tAiNgUyEnVaNn/Analog-Electronics/Nhóm 10_Report_Final.pdf

# BÁO CÁO BÀI TẬP LỚN

Học phần: Điện tử tương tự 1 | Mã Lớp:150141 | Thời khóa biểu: Thứ 3, phòng: TC-308

Nhóm số: 10

Họ tên | MSSV | Phân công công việc
Nguyễn Văn Tài | 20214082 | - Tính toán thông số lý thuyết mạch nguyên lý - Hiệu chỉnh mạch - Thiết kế PCB, đặt hàng và hàn PCB - Làm báo cáo phần phân tích thiết kế; tính toán lý thuyết; kết luận
Lê Văn Minh | 20214001 | - Mô phỏng mạch và đo thông số mô phỏng - Làm báo cáo phần mô phỏng mạch
Đặng Thanh Hải | 20210310 | - Thực hiện mạch thử nghiệm trên breadboard; đo thông số thực tế trên breadboad và PCB - Làm báo cáo phần đo đạc thực tế
Đoàn Minh Quang | 20214047 | - Tham chiếu thông số yêu cầu và chọn linh kiện phù hợp - Tổng hợp số liệu lý thuyết, mô phỏng, thực tế và đánh giá sai số, nguyên nhân sai số (nếu có)

==================================================================================

Đề tài số: 06

Yêu cầu thiết kế: Thiết kế mạch khuếch đại âm thanh đáp ứng các yêu cầu kỹ thuật: công suất ra trên tải 1.5W, tải loa 4 Ω, tín hiệu đầu vào hiệu dụng 100mV.

==================================================================================

### 1. PHÂN TÍCH THIẾT KẾ

Phân tích: Do công suất ra là Pout = 1. 5 W, điện trở loa là RL = 4 Ω, sử dụng nguồn nuôi 12V

Nên điện áp đầu ra của mạch khuếch đại chế độ đẩy kéo AB là Vout, rms = √Pout ∗ RL ≈ 2.5 Vrms

Tầng 1 là tầng khuếch đại điện áp. Các tầng 2 và 3 chỉ cần khuếch đại dòng điện, không cần khuếch đại điện áp, nên điện áp ra của tầng 1 chính là xấp xỉ điện áp ra của toàn mạch. Nên:

Vout1, rms > 2.5 V

Do yêu cầu đề bài điện áp hiệu dụng tín hiệu vào là 100mV. Nên từ đo ta tính toán được hệ số khuếch đại điện áp tối thiểu của tầng 1:

AV1 >

Vout1, rms

Vin, rms

= 25 (lần)

Yêu cầu đáp ứng tần số toàn mạch tối thiểu nằm trong vùng từ 100Hz đến 10Khz

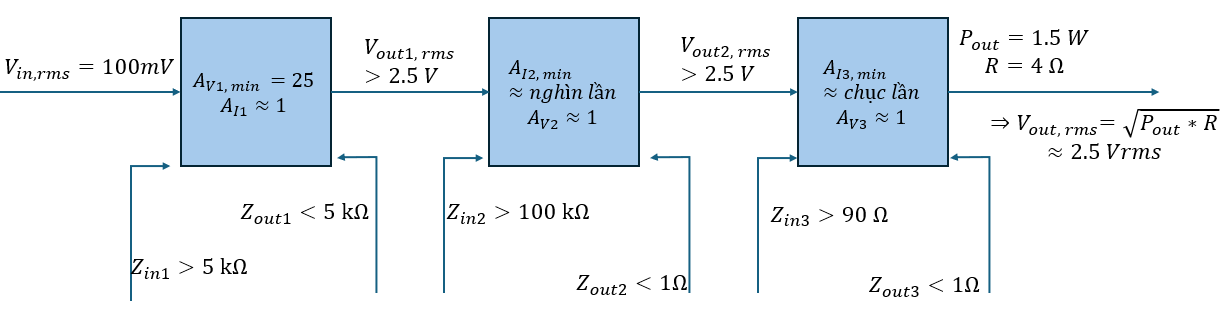
[picture p1: figure]

### 1.1. Tầng khuếch đại 1 (Khuếch đại điện áp)

- Yêu cầu tầng khuếch đại 1:
- AV1 > 25 (lần)
- Để phối hợp trở kháng tốt với nguồn và các tải: Zin1 > 5kΩ và Zout1 < 5kΩ
- Đáp ứng tần số: f ε (20Hz; 20kHz)
- Kiến trúc sử dụng: Tầng khuếch đại tín hiệu E chung (CE), phân cực theo kiểu phân áp (Voltage divide)
- Transitor sử dụng: 2N2222A

### 1.2. Tầng khuếch đại 2 (Khuếch đại dòng điện)

Do dòng điện từ đầu vào không được khuếch đại ở tầng đầu tiên thậm chí còn bị suy giảm bởi phối hợp trở kháng. Nên nếu đưa tín hiệu trực tiếp vào tầng khuếch đại công suất, đường tải tĩnh bị thấp xuống dẫn đến công suất cũng như hiệu suất bị suy giảm. Tầng khuếch đại 2 này cũng được sử dụng như một bộ đệm tín hiệu (đáp ứng phối hợp trở kháng giữa tầng 1 và tầng 3)
- Yêu cầu tầng khuếch đại 2:
- AI2 ≈ vài ngℎìn lần
- Để phối hợp trở kháng tốt giữa tầng 1 và tầng 3: Zin2 > 100kΩ và Zout2 < 1Ω
- Đáp ứng tần số: f ε (20Hz; 20kHz)
- Kiến trúc sử dụng: Tầng khuếch đại tín hiệu C chung (CC), mắc theo kiểu Darlington
- Transistor sử dụng: 2N2222A và TIP41C (do cần phải chịu dòng điện cao)

### 1.3. Tầng khuếch đại 3 (Khuếch đại công suất)

- Yêu cầu tầng khuếch đại 3:
- AI3 ≈ vài cℎục lần
- Để phối hợp trở kháng tốt giữa tầng 2 và loa: Zin3 > 90Ω và Zout3 < 1Ω
- Đáp ứng tần số: f ε (20Hz; 20kHz)
- Kiến trúc sử dụng: Tầng khuếch đại công suất đẩy kéo chế độ AB, mắc theo kiểu C chung (CC)
- Transistor sử dụng: TIP41C và TIP42C (do làm việc với công suất cao)

### 2. TÍNH TOÁN LÝ THUYẾT

### 2.1. Tầng khuếch đại 1 (Khuếch đại điện áp)

Dựa vào kiến trúc và yêu cầu của phần 1. Ta có sơ đồ cần thực hiện như sau:

Chọn
{

Transistor: 2N2222A có {

β = 300
VBEon ≈ 0.7 V
VT =

kq
T (°K)

= 26 mV
Hệ số kℎuếcℎ đại: G = 30 lần Tần số ℎoạt động: (20Hz ÷ 20kHz)

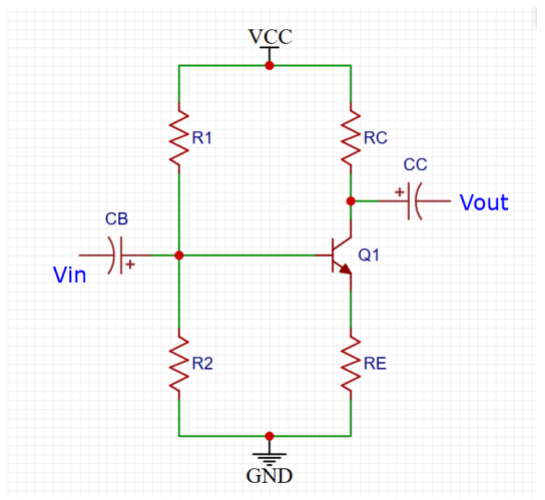
[picture p2: figure]

Đối với BJT ứng dụng khuếch đại, ta cần phân cực điểm Q nằm trong vùng tích cực (active region). Để hạn chế tín hiệu ra bị méo và để tăng hiệu suất tầng khuếch đại công suất, nên điểm Q cần nằm chính giữa đường tải tĩnh. Nên:

ICQ =

ICmax
2

=

VCC
2(RC + RE)

⇔ RE =

VCC
2IC

− RC (2.1.1)

Đối với mạch khuếch đại E chung, hệ số khuếch đại điện áp của mạch là (coi như dùng giá trị tuyệt đối):

G =

RC
1
gm

+ RE

⇔ G (

VT
IC

+

VCC
2IC

− RC) = RC ⇔ IC =

G(VCC + 2VT

| )
2RC(1 + G)

(2.1.2)

Ta có thể thấy biểu thức 2.1.2 chỉ rõ sự phụ thuộc của Ic vào Rc thỏa mãn điều kiện ở công thức 2.1.1 (điểm Q nằm chính giữa đường tải tĩnh). Đồng thời với việc để chọn giá trị trở theo các giá trị mặc định của nhà sản xuất (hạn chế việc nối tiếp nhiều trở), ta thấy RC tăng thì hệ số khuếch đại tăng nhưng trở kháng ra lại giảm. Nên để cân bằng thông thường ta chọn Rc trong khoảng từ (1kΩ ÷ 10kΩ).

Ta chọn RC = 2 kΩ ⇒ {
IC =

30∗(12+2∗26(mV)
2∗2(kΩ)∗(1+30)

≈ 2.92 mA

RE =

12
2∗2.92(mA)

−2(kΩ) ≈ 54.8 Ω. Cℎọn RE = 56 Ω

Điện áp tại cực B được tính theo 2 cách: Theo phân áp qua R1, R2 và thông qua định luật Kirchoff về điện áp:

VB = VCC

R2
R1 + R2

= VBEon + ICRE ⇔ R1 =

VCCR2

VBEon + ICRE

− R2

R1
R1 + R2

=

VB

VCC

=

0.7 +2.92m ∗ 56
12 | ≈ 0.08

Ta thấy, giá trị IC cỡ mA, nên giá trị IB nhỏ cỡ μA. Do đó, giá trị IB có thể xấp xỉ 0. Khi đó, R1 và R2 có thể được coi là nối tiếp nhau, và IR1 ≫ IB. Thông thường ta lấy:

IR1 ≥ 10IB ⇔ R1 ≤

VR1
10IB

=

β(VCC − VB)
10IC

=

300 ∗ (12 − 0.7 − 2.92(mA) ∗ 56)
| 10 ∗ 2.92(mA)

≈ 114 kΩ

Chọn R1 = 100 kΩ ⇒ R2 =

(0.7+2.92m∗56)∗100k
12−0.7−2.92m∗56

≈ 9.4kΩ. Nên cℎọn R2 ≈ 10kΩ.

Tính toán lại các thông số 1 chiều và xoay chiều:

Chế độ 1 chiều (DC mode): IC = β

VTH−VBEon
RTH+(β+1)RE

≈ 3.2 mA ≈

VCC 2(RC+RE) | = 2.92 mA ⇒ Q nằm gần giữa đường tải

VCE = VCC −IC

(RC +RE

) = 12 − 3.2m ∗ (2k + 56) = 5.4 (V)

Chế độ xoay chiều (DC mode):

{

AV,1 = −

RC
VT
IC

+RE

≈ −31 lần

Zin,1 = R1 ∥ R2 ∥ [(rπ + (1 + β) ∗ RE

] ≈ 100k ∥ 10k ∥ 19k ≈ 6 kΩ; Với rπ =

β
gm
Zout,1 ≈ RC = 2 kΩ

Đáp ứng tần số: Các tụ nối tầng mắc theo kiểu DC-Block tạo thành mô hình lọc thông cao (HPF)

fLB =

1
2πZinCB

< fL Hz ⇒ CB >

1
2πfLZin

=

1
2π ∗ 20 ∗ 6k

≈ 1.32 (μF). Cℎọn CB = 47μF do pℎổ biến

fLC =

1

2πZoutCC

< fL ⇒ CC >

1

2πfLZout

=

1
2π ∗ 20 ∗ 2k

≈ 4 (μF). Cℎọn CC = 47uF do pℎổ biến

### 2.2. Tầng khuếch đại 2 (Khuếch đại dòng điện)

Dựa vào kiến trúc và yêu cầu của phần 1: Mạch khuếch đại C chung, mắc theo kiểu Darlington để tăng hệ số khuếch đại dòng điện. Ta có sơ đồ cần thực hiện như sau:

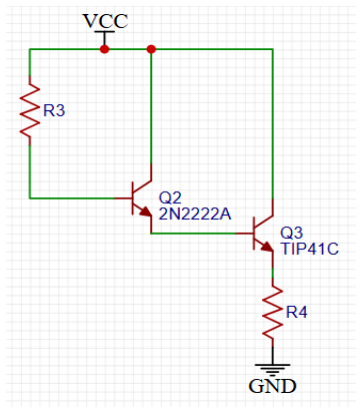
[picture p3: figure]

Với: {

2N222A (Q2): {

VBEon ≈ 0.7 V
β2 = 300
TIP 41C (Q3): {

VBEon ≈ 0.67 V
β3 = 35

IC3 = βD

VCC − VBED
R3 + βDR4

Để điểm làm việc tĩnh của Q3 nằm chính giữa đường tải: IC3 =

1
2

IC3,max =

1
2

VCC
R4

⇔ βD

VCC − VBED
R3 +βDR4

=

1
2

VCC
R4

⇔ RB =

βDRE(VCC − VBED)

VCC

Mặt khác VCE là vùng sinh của tín hiệu xoay chiều. Nên tín hiệu đầu ra của tầng 1 không được vượt quá VCE3.

Ta chọn R4 = 33 (Ω) => R3 ≈ 208 (kΩ). Cℎọn R3 = 200 (kΩ)

Tính toán lại các thông số 1 chiều và xoay chiều:

Chế độ 1 chiều (DC mode):
{

IC3 =

Vcc−VBED
R3+βDR4

≈ 184 mA ≈

VCC
2R4

= 181 mA ⇒ Q nằm giữa đường tải VCE3 = VCC −IC ∗ R4 = 12 − 181m ∗ 33 = 6.027 V IC2 =

IC3
β3

=

181m
35

≈ 5.17 mA
VCE2 = VCC − VE3 − VBE3 = 12− 8.507 − 0.67 = 5.3 V

Chế độ xoay chiều (AC mode):
{

AI,2 ≈ −

βDR3
R3+βDR4

≈ 6060 lần
Zin,2 = R3 ∥ βDR4 = 200k ∥ 346k ≈ 126 kΩ

Zout,2 =

1
gm2β3

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
≈ 0.14 Ω
AV,2 ≈ 1 lần

### 2.3. Tầng khuếch đại 3 (Khuếch đại công suất)

Ở tầng khuếch đại công suất, ta sử dụng mô hình khuếch đại công suất đẩy-kéo chế độ AB. Vì ở chế độ này, mỗi transitor khuếch đại một nửa chu kỳ nên hiệu suất của mạch đạt tốt hơn. Cùng với đó, công suất tiêu tán của tầng khuếch đại công suất được chia cho 2 transistor nên nhiệt tỏa ra của mỗi transistor sẽ giảm, nên transistor sẽ bền hơn.
{
TIP41C (Q4) và TIP42C (Q5): {

VBEon ≈ 0.67 V
β4 = β5 = 35 lần
Diode (1N4007)D1 và D2: VBEon ≈ 0.7 V

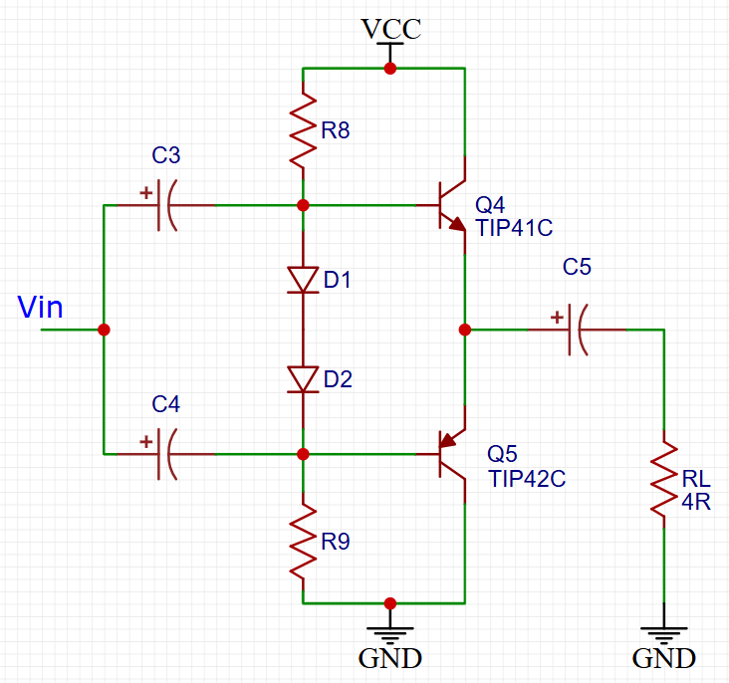
[picture p4: figure]

Nguyên lý hoạt động:

- Ở nửa chu kỳ dương: Q4 mở, Q5 ngắt. Tín hiệu AC từ Vin qua Q4 được đưa ra tải RL đồng thời tụ C5 được nạp bởi tín hiệu DC
- Ở nửa chu kỳ âm: Q4 ngắt, Q5 mở. Tụ C5 phóng điện làm nguồn nuôi của Q5 ở nửa chu kỳ âm. Nên tụ C5 cần có giá trị lớn. Tín hiệu từ Vin qua Q5 được đưa ra tải
- 2 diode tạo điện áp rơi xấp xỉ điện áp mở của Q4 và Q5, tạo phân cực ban đầu và cải thiện hiện tượng méo xuyên tâm (cross over distortion).

Do mạch khuếch đại ở chế độ AB nên điểm Q được phân cực sát với vùng cut-off {

VCEQ ≈ VCEmax

ICQ ≪ ICmax =

VCC
RL

≈ 3A

Ta có thể quan sát thấy đây là 2 mạch khuếch đại mắc theo kiểu C chung hoạt động độc lập ở 2 nửa chu kỳ. Dòng điện qua điện trở R8 bằng dòng điện qua điện trở R9. Nên R8=R9:

IR8 =

VCC − VD1 − VD2
2R8

Chọn R8 = 430 Ω ⇒ IR8 ≈ 12.3 (mA). Giá trị của IB nhỏ hơn dòng điện qua điện trở R8 do diode không lý tưởng thường tồn tại trở kháng.

Lấy IBQ,4 = −IBQ,5 ≈ 8 (mA) => ICQ,4 = ICQ,5 ≈ 280 (mA) ≪ ICmax ⇒ gm4 = gm5 ≈ 10,76 (S)

⇒ rπ4 = rπ5 =

β
gm

≈ 3.25 Ω

Tính toán lại các thông số 1 chiều và xoay chiều:

Chế độ 1 chiều (DC mode): IC3 =

Vcc−VBED
R3+βDR4

≈ 184 mA ≈

VCC
2R4

= 181 mA ⇒ Q nằm giữa đường tải

Chế độ xoay chiều (AC mode): {

AV ≈ 1 lần
Zin,3 = R8 ∥ R9 ∥ (rπ4 + (1 + β4

)RL

) = 235 ∥ 148 ≈ 91Ω

Zout,3 =

1

gm4

≈ 0.1 Ω

### 2.4. Tính hệ số khuếch đại điện áp toàn mạch và hiệu suất khuếch đại công suất

Hệ số khuếch đại điện áp toàn mạch:

AV,total = AV,1

Zin,2

Zin,2 +Zout1

AV,2

Zin,3

Zin,3 + Zout,2

AV,3

RL

RL + Zout,3

≈ 27 (lần)

Điện áp ra trên tải là: VL

(rms) = 27 ∗ 100(mVrms) = 2.7 (Vrms)

Công suất đưa ra tải: Pout, calc =

2.7

2

4

≈ 1.8 (W)

Công suất tiêu thụ tầng khuếch đại công suất: Pi (dc) = VCCIdc = VCC

2
π

VL(rms)√2
RL

≈ 7.3 (W)

Hiệu suất khuếch đại công suất: %η =

Pout, calc
Pi

(dc)

≈ 24.6 %

Công suất tiêu tán trên mỗi transistor: Pd, Q4 = Pd, Q5 = 2.75 (W)

### 2.5. Giải thích chức năng cần thiết của từng tầng

- Tầng 1: Là tầng khuếch đại tín hiệu nhỏ, liên quan trực tiếp tới công suất đầu ra được cho bởi công

thức: Pout =

AV ∗ Vin, rms

2

RL
- Tầng 2: Là tầng khuếch đại dòng điện, đồng thời là tầng “đệm” để phối hợp trở kháng giữa tầng 1 và tầng 3. Do Zout1 cỡ kΩ , Zin3 cỡ 100Ω. Nên nếu nối trực tiếp tầng 1 và tầng 3 mà không thông qua tầng Darlington thì phối hợp trở kháng không tốt dẫn đến tín hiệu bị suy hao khi đi vào tầng 3

### 3. MÔ PHỎNG MẠCH VÀ ĐO ĐẠC

### 3.1. Mô phỏng mạch ở chế độ một chiều (DC mode)

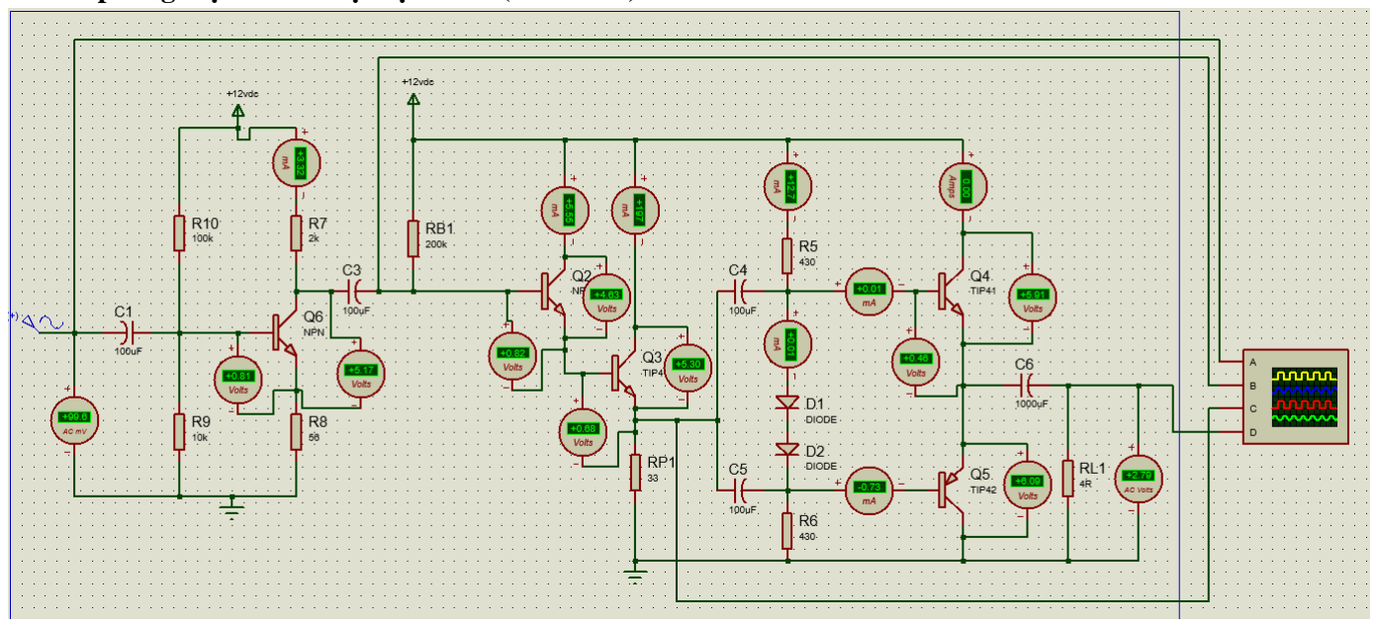
[picture p5: figure]

Kết quả mô phỏng được trình bày ở phần So sánh, đánh giá, nhận xét

### 3.2. Mô phỏng mạch ở chế độ xoay chiều (AC mode). Với Vin(rms) = 100 (mV), f = 1 (kHz)

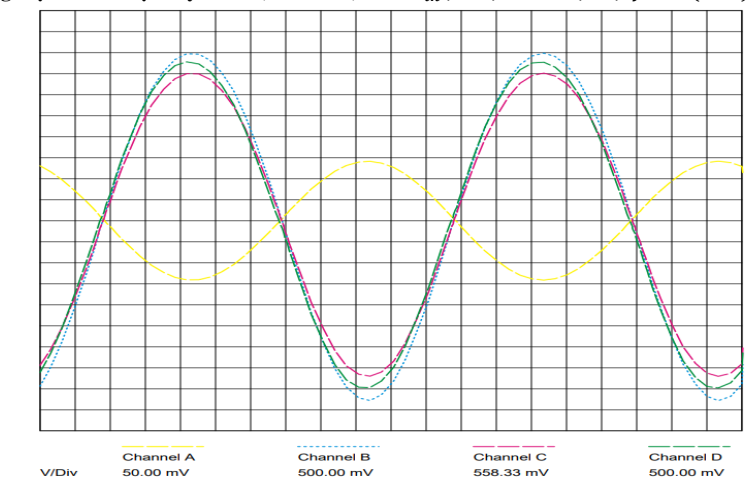
[picture p6: figure]

Nhận xét: Các kết quả đo được gần đúng với kết quả tính toán bên trên.

Thông số | Kết quả tính toán | Kết quả mô phỏng
AV | 27 lần | 27.5 lần
Pout | 1.8 W | 1.89 W
Hiệu suất | 24.6% | 25.4%

### 3.3 Đánh giá đáp ứng tần số:

Từ thiết kế cho dải tần số làm việc ở 20 Hz - 20kHz. Ta khảo sát hệ số khuếch đại điện áp toàn mạch theo sự thay đổi của tần số tín hiệu đưa vào, kết quả thu được ở bảng sau:

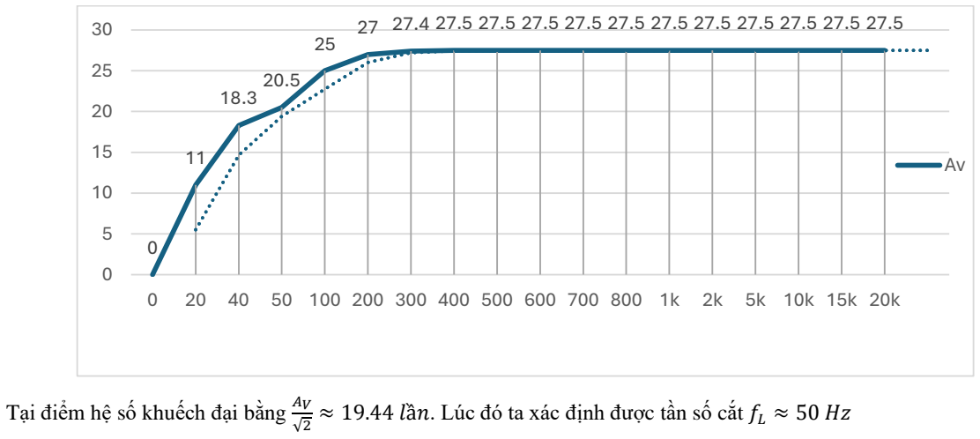
[picture p7: figure]
Tại điểm hệ số khuếch đại bằng

≈ 19.44 lần. Lúc đó ta xác định được tần số cắt fL ≈ 50 Hz

Như vậy mạch đáp ứng tốt trong khoảng tần số: (50Hz − 20kHz)

### 3.4. Đánh giá hiệu quả phối hợp trở kháng:

Hệ số khuếch đại điện áp tầng 1 (theo mô phỏng xấp xỉ 30 lần). Hệ số khuếch đại toàn mạch xấp xỉ 27.5 lần

27 27.4 27.5 27.5 27.5 27.5 27.5 27.5 27.5 27.5 27.5 27.5 27.5

### 0 20 40 50 100 200 300 400 500 600 700 800 1k 2k 5k 10k 15k 20k

### 4. THỰC HIỆN MẠCH VÀ ĐO ĐẠC

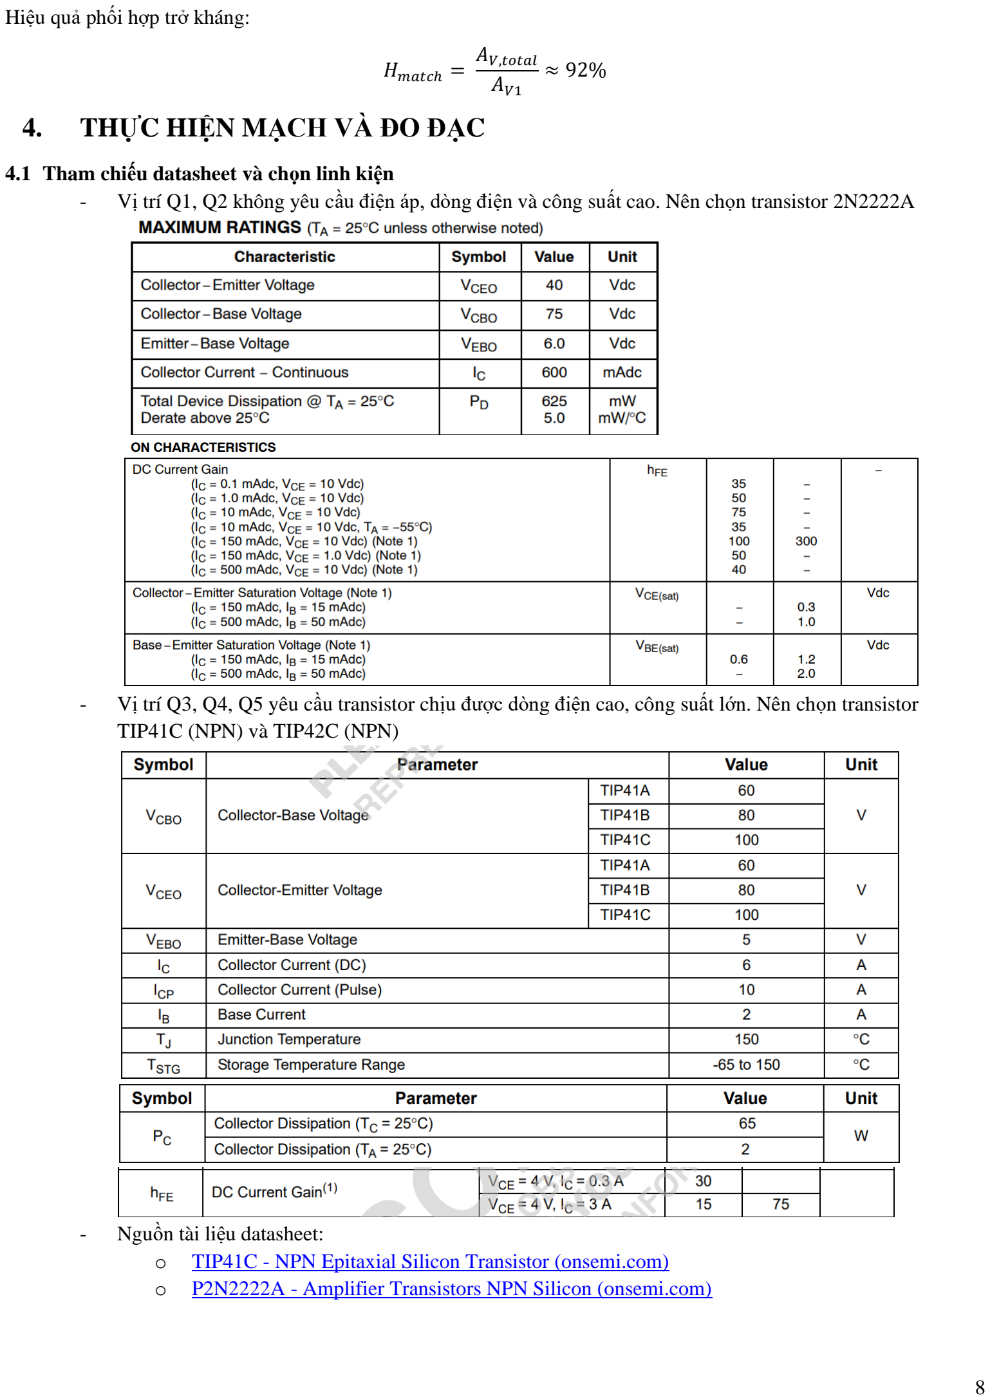
[picture p8: page 8]

Hiệu quả phối hợp trở kháng:

Hmatcℎ =

AV,total

AV1

≈ 92%

### 4.1 Tham chiếu datasheet và chọn linh kiện

- Vị trí Q1, Q2 không yêu cầu điện áp, dòng điện và công suất cao. Nên chọn transistor 2N2222A
- Vị trí Q3, Q4, Q5 yêu cầu transistor chịu được dòng điện cao, công suất lớn. Nên chọn transistor TIP41C (NPN) và TIP42C (NPN)
- Nguồn tài liệu datasheet:
- TIP41C - NPN Epitaxial Silicon Transistor (onsemi.com) (https://www.onsemi.com/pdf/datasheet/tip41c-d.pdf)
- P2N2222A - Amplifier Transistors NPN Silicon (onsemi.com) (https://www.onsemi.com/pdf/datasheet/p2n2222a-d.pdf)

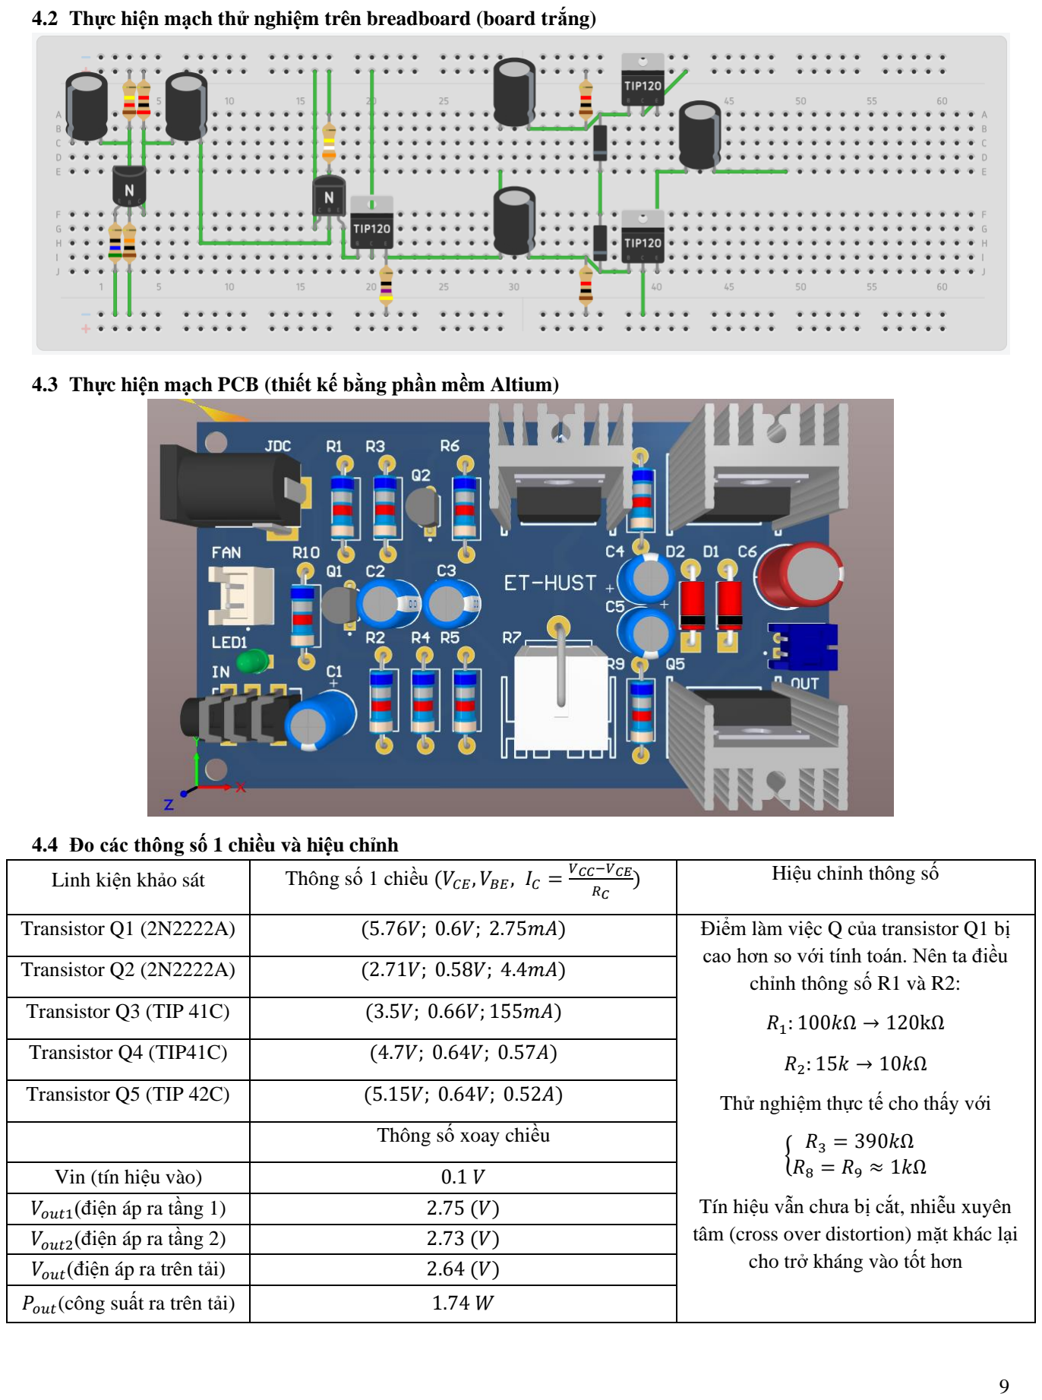
[picture p9: page 9]

### 4.2 Thực hiện mạch thử nghiệm trên breadboard (board trắng)

### 4.3 Thực hiện mạch PCB (thiết kế bằng phần mềm Altium)

### 4.4 Đo các thông số 1 chiều và hiệu chỉnh

Linh kiện khảo sát | VCC−VCE ) Thông số 1 chiều (VCE, VBE, IC = RC | Hiệu chỉnh thông số
Transistor Q1 (2N2222A) | (5.76V; 0.6V; 2.75mA) | Điểm làm việc Q của transistor Q1 bị cao hơn so với tính toán. Nên ta điều chỉnh thông số R1 và R2: R1 : 100kΩ → 120kΩ R2 : 15k → 10kΩ Thử nghiệm thực tế cho thấy với R3 = 390kΩ { R8 = R9 ≈ 1kΩ Tín hiệu vẫn chưa bị cắt, nhiễu xuyên tâm (cross over distortion) mặt khác lại cho trở kháng vào tốt hơn
Transistor Q2 (2N2222A) | (2.71V; 0.58V; 4.4mA)
Transistor Q3 (TIP 41C) | (3.5V; 0.66V; 155mA)
Transistor Q4 (TIP41C) | (4.7V; 0.64V; 0.57A)
Transistor Q5 (TIP 42C) | (5.15V; 0.64V; 0.52A)
| Thông số xoay chiều
Vin (tín hiệu vào) | 0.1 V
Vout1 (điện áp ra tầng 1) | 2.75 (V)
Vout2 (điện áp ra tầng 2) | 2.73 (V)
Vout(điện áp ra trên tải) | 2.64 (V)
Pout (công suất ra trên tải) | 1.74 W

### 4.5 Đánh giá

Các thông số đo được sai lệch so với thực tế do sai số về linh kiện, nên cần phải điều chỉnh lại

Các thông số thực tế của mạch sau điều chỉnh ở tầng 1 giúp điểm Q ở vị trí tốt hơn so với ban đầu (nằm gần chính giữa đường tải) và phối hợp trở kháng tốt hơn giữa các tầng

### 5. SO SÁNH, ĐÁNH GIÁ, NHẬN XÉT

### 5.1 Bảng so sánh các giá trị khảo sát

Vị trí khảo sát | Giá trị thiết kế | Giá trị mô phỏng | Giá trị thực tế
Nguồn nuôi | | 12V | 12V | 11.5 V
Điểm làm việc tĩnh Q point | Transistor Q1 (2N2222A) | (5.4V; 0.7V; 2.92mA) | (6.14V; 0.8V; 2.85mA) | (5.76V; 0.6V; 2.75mA)
| Transistor Q2 (2N2222A) | (5.3V; 0.7V; 5.17mA) | (4.58V; 0.82V; 5.64mA) | (2.71V; 0.58V; 4.4mA)
| Transistor Q3 (TIP 41C) | (6.02V; 0.67V; 181mA) | (5.26V; 0.68V; 200mA) | (4.2V; 0.66V; 155mA)
| Transistor Q4 (TIP41C) | (6V; 0.7V; 0.27A) | (6V; 0.69V; 0.29A) | (4.7V; 0.64V; 0.57A)
| Transistor Q5 (TIP 42C) | (6V; 0.7V; 0.27A) | (6V; 0.69V; 0.29A) | (5.65V; −0.65V; 0.52A)
Điện áp xoay chiều từng tầng | Vin (điện áp xoay chiều vào) | 0.1 V | 0.1 V | 0.1 (V)
| Vout1 (điện áp ra của tầng 1 | 2.8 V | 3.0 V | 2.75 (V)
| Vout2 (điện áp ra của tầng 2) | 2.78 V | 2.8 V | 2.73 (V)
| Vout, total(điện áp ra trên tải) | 2.7 V | 2.75 V | 2.64 (V)
Công suất trên tải | Yêu cầu 1.5W | 1.8W | 1.89W | 1.74 W
Đáp ứng tần số | Yêu cầu 30hz-20khz | 50Hz − 20kHz | 50Hz − 20kHz | 50Hz −17kHz
Hiệu suất | | 24.6 % | 25.4 % | 24.4 %
Hiệu quả phối hợp trở kháng | Yêu cầu >90% | 96.4 % | 92 % | 96 %

### 5.2 Đánh giá

Các thông số tính toán lý thuyết, mô phỏng và thực tế có sự sai khác tuy nhiên không nhiều; đáp ứng được yêu cầu thiết kế. Các sự sai khác chủ yếu đến từ linh kiện như:

- Điện trở sai số 5% theo nhà sản xuất;
- Transistor có sự ảnh hưởng của nhiệt độ thực tế mà mô phỏng và tính toán không tính đến;

### 5.3 Nhận xét

Mạch thực hiện đáp ứng các yêu cầu thiết kế ban đầu: Nguồn nuôi 12V, điện áp vào 100mV; công suất ra 1.5W

So sánh hiệu suất chế độ A và AB khi thực hiện ở mạch hiện tại

Thông số | Chế độ A | Chế độ AB
Hiệu suất | Tối đa 25% khi không mắc biến áp. Có thể lên đến 50% khi mắc biến áp | 24.4%
Công suất transistor phải chịu (giả sử với công suất ra tải là 1.9W) | 5.2W | 2.7 W cho mỗi transistor
Phi tuyến | Tín hiệu đầu ra (Output voltage wings) có thể bị cắt (clipped) do 1 transistor phải khuếch đại cả 2 nửa chu kỳ | Tín hiệu đầu ra cải thiện hơn trong trường hợp tín hiệu đầu vào lớn hơn do mỗi transistor chỉ cần khuếch đại 1 nửa chu kỳ

Tầng khuếch đại 1 dùng kiến trúc CE cho hệ số khuếch đại điện áp tốt nhưng dễ gây vấn đề về phi tuyến và khó phân cực điểm làm việc tĩnh Q giữa đường tải. Có thể khắc phục bằng cách mắc khuếch đại vi sai

Việc đưa tín hiệu đầu vào quá cao hoặc hệ số khuếch đại điện áp tầng đầu tiên quá cao dẫn đến điện áp đầu ra tầng 1 tức điện áp đầu vào của tầng 2 vượt quá vùng tuyến tính sang vùng phi tuyến dẫn đến méo dạng tín hiệu ở 2 đỉnh.

Tầng khuếch đại 2 dùng kiến trúc Darlington cho hệ số khuếch đại dòng điện tốt tuy nhiên gây vấn đề về nhiệt trên điện trở, transistor công suất; và tiêu tốn năng lượng.

Tầng khuếch đại 3 dùng kiến trúc đẩy kéo chế độ AB ưu điểm cho hiệu suất năng lượng tốt, năng lượng thất thoát chuyển hóa thành nhiệt sẽ được phân bố trên 2 transistor TIP 41C và TIP 42C.

Tín hiệu ra loa bị nhiễu khi chưa cấp tín hiệu vào do nhiễu nền NF (Noise Figure) do các linh kiện gây ra

Vấn đề nguồn nuôi: Nguồn nuôi bị sụt áp khi có tải. Có thể dùng nguồn cao hơn (khoảng 15V) rồi dùng IC ổn áp LM7812 để ổn định nguồn nuôi

--------------------------------------------------------------Hết--------------------------------------------------------------
