tAiNgUyEnVaNn/Analog-Electronics/pcb.pdf

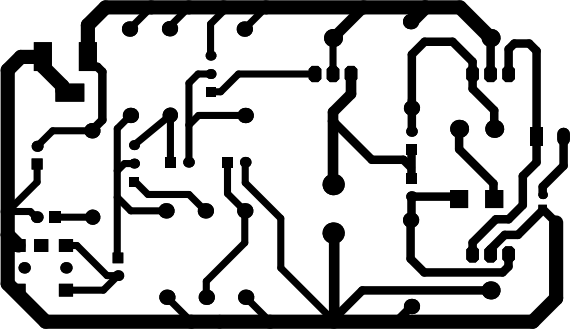
[picture p10: figure]
