tAiNgUyEnVaNn/Analog-Electronics/Sim result.pdf

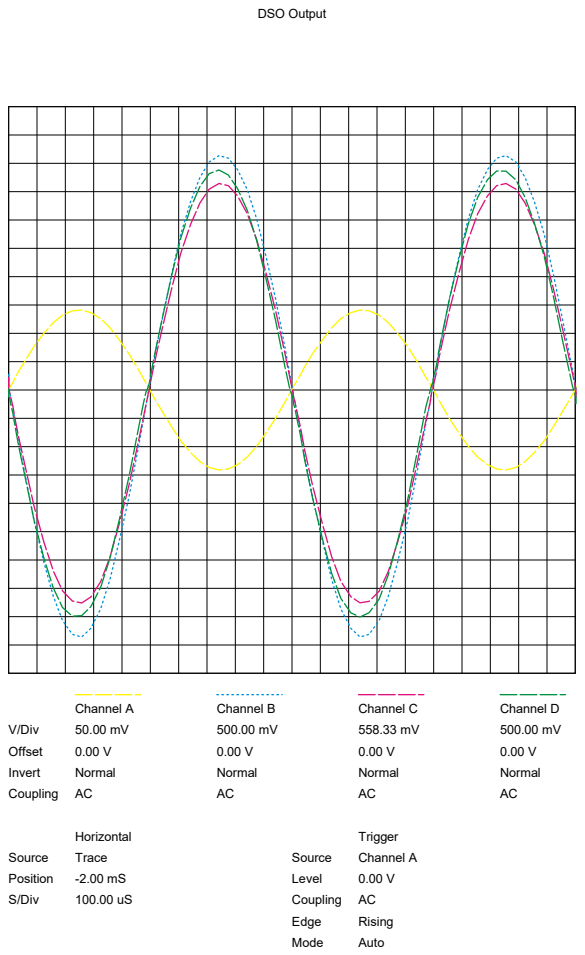
[picture p11: page 1]
DSO Output; V/Div; Offset; Invert; Coupling; Channel A; Normal; Channel B; Channel C; Channel D; Horizontal; Source; Position; S/Div; Trace; Trigger; Level; Edge; Mode; Rising; Auto
