tAiNgUyEnVaNn/Analog-Electronics/Schematic simulation.pdf

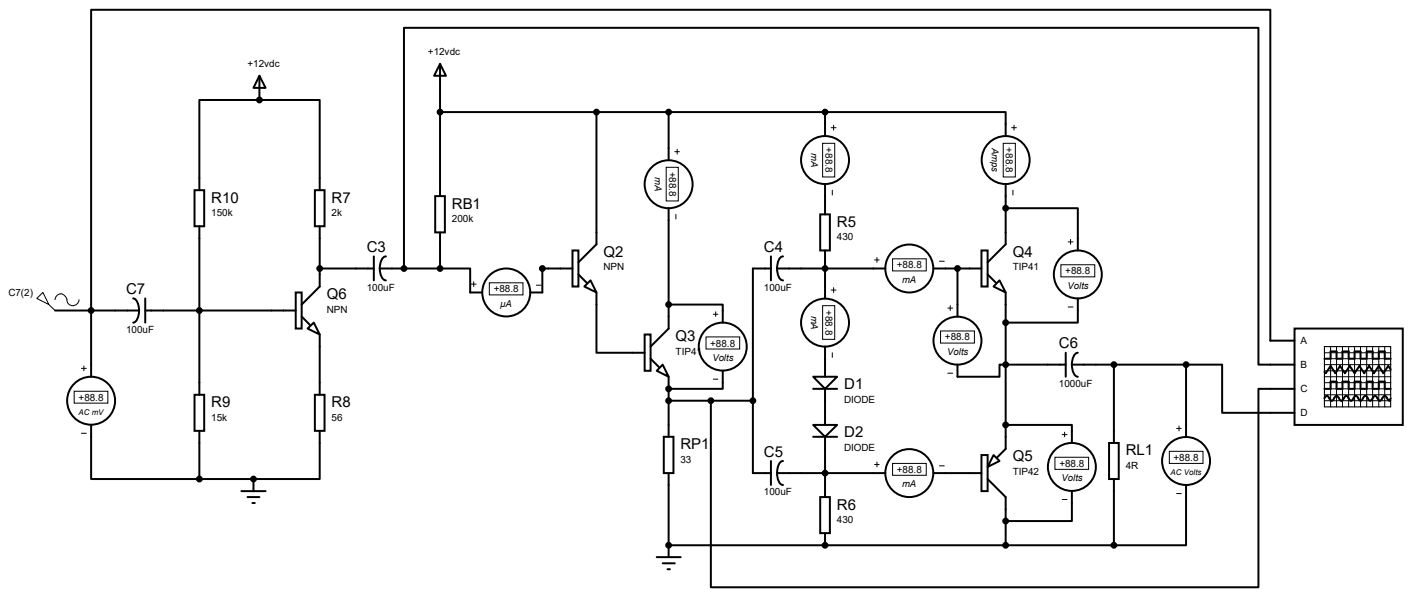
[picture p12: page 1]

AC Volts ⁺⁸⁸.8 mA
