tAiNgUyEnVaNn/Analog-Electronics/(list of files, drawings)

Other design files:
Amp.pdsprj
