tAiNgUyEnVaNn/Analog-Electronics/(commit log)

2025-05-16 Gerber File
    Gerber File
2025-05-16 PCB
    PCB
